prom1alp/heartin-hardware/PCB/Montage/pcbX1 comment.jpg

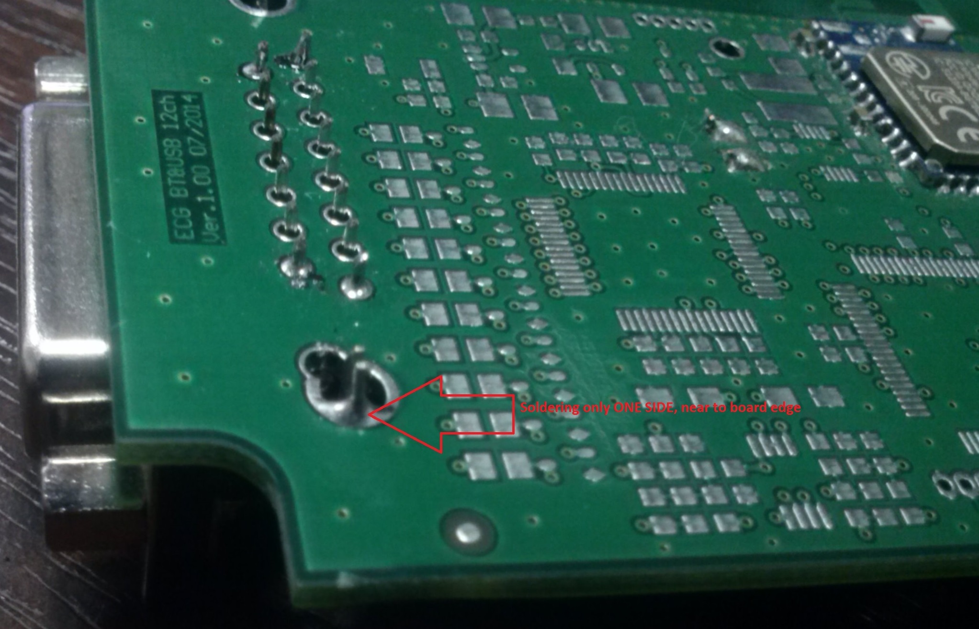
PCB/Montage/pcbX1 comment.jpg
