prom1alp/heartin-hardware/PCB/Montage/pcb overview.jpg

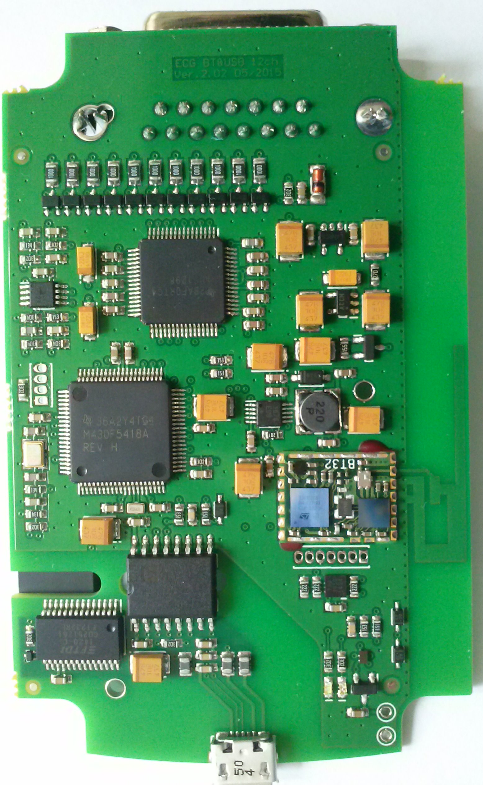
PCB/Montage/pcb overview.jpg
