prom1alp/heartin-hardware/PCB/Gerber/readme.txt

Имя:            ECG BT&USB 12ch Ver.2.02 05/2015
Тип:		4-х слойная печатная плата
Материал:	FR4
Размер:		54.61x87.50 мм (2.150'x3.445')
Толщина:	1.5мм
Электроконтроль:Да

Описание слоев:
TOP.GBR - проводники верхнего слоя
IN1.GBR - проводники внутреннего слоя 1
IN2.GBR - проводники внутреннего слоя 2
BOT.GBR	- проводники нижнего слоя
SMT.GBR - защитная маска верхнего слоя
SMB.GBR - защитная маска нижнего слоя
SST.GBR - маркировка верхнего слоя
SSB.GBR - маркировка нижнего слоя
BRD.GBR - контур платы

SPT.GBR	- паяльная паста верхнего слоя

Format:	RS274X, 2.4, Abs, Inch, Leading
Последовательность слоев: TOP-IN1-IN2-BOT

THRUHOLE.DRL	- файл сверловки метализированных отверстий

Format: Excellon 2, 2.4, Abs, Inch, Leading
