prom1alp/heartin-hardware/!Overview/box.png

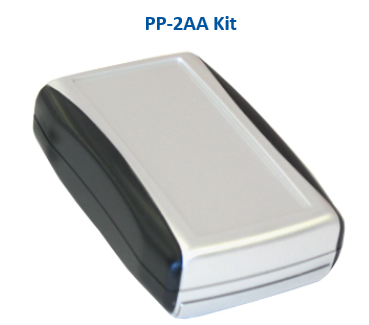
!Overview/box.png
