prom1alp/heartin-hardware/!Overview/box_overview.jpg

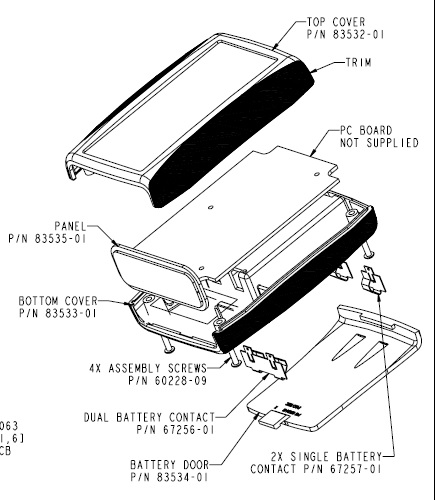
!Overview/box_overview.jpg
