prom1alp/heartin-hardware/!Overview/box_panel_milling.jpg

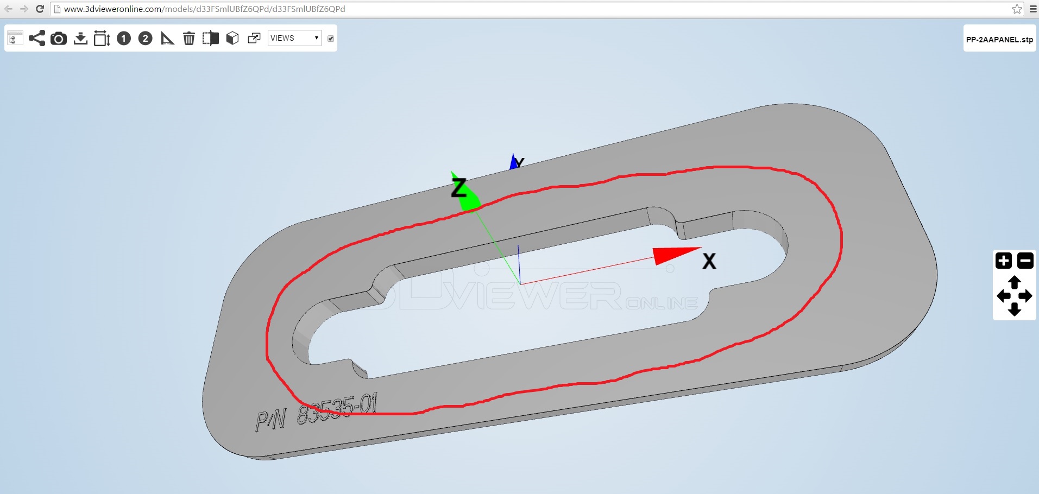
!Overview/box_panel_milling.jpg
