prom1alp/heartin-hardware/!Overview/box_top_milling.jpg

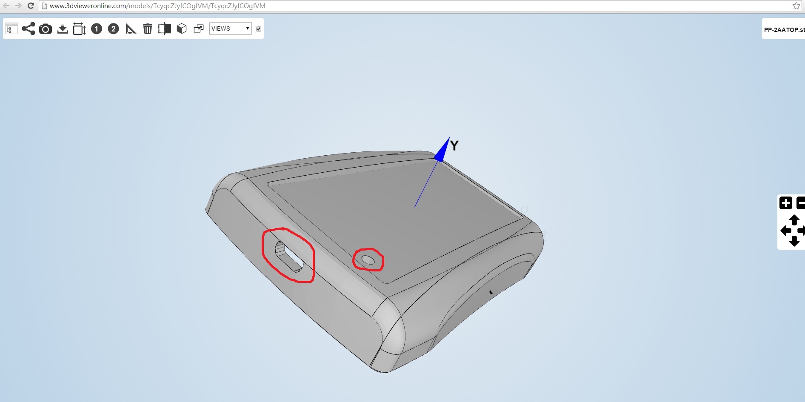
!Overview/box_top_milling.jpg
