prom1alp/heartin-hardware/Specification/drb-15f.jpg

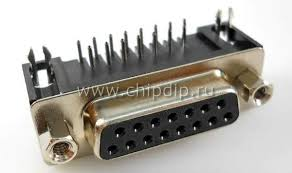
Specification/drb-15f.jpg
