prom1alp/heartin-hardware/Specification/pp-2aa.png

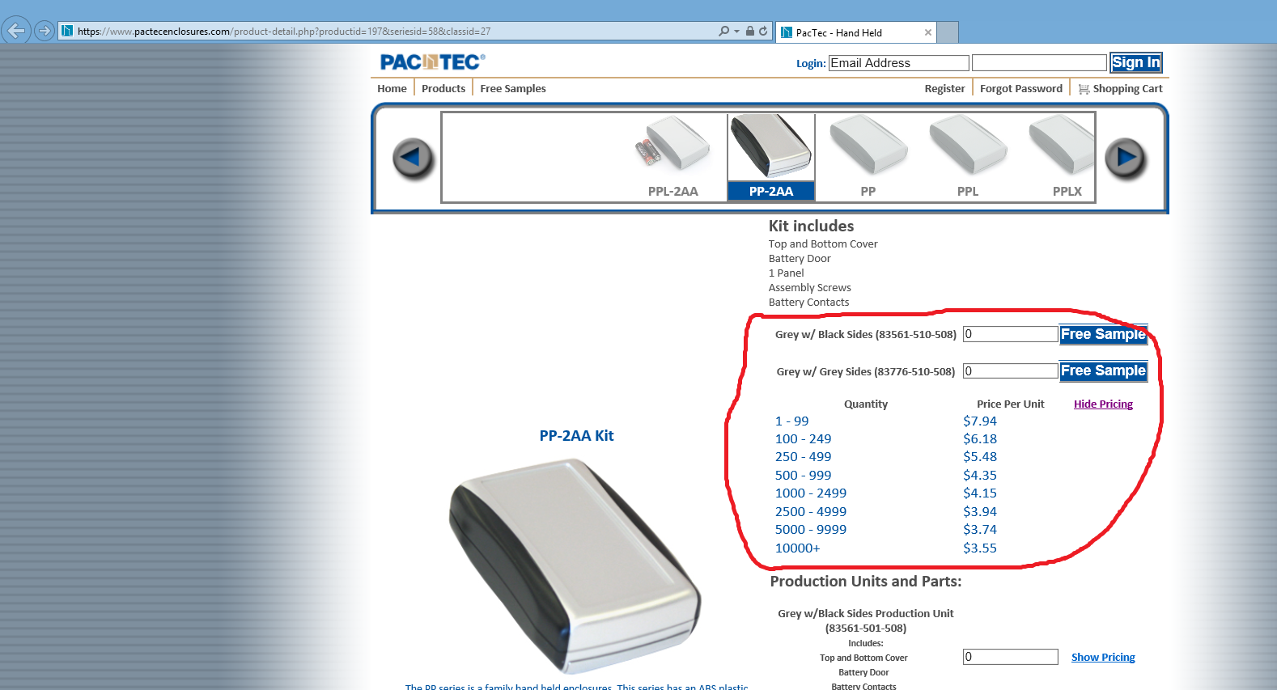
Specification/pp-2aa.png
