prom1alp/heartin-hardware/Specification/USB+BT+MFi (Apple)/Spec ECG BT&USB 12ch Ver.2.02 mod USB+BT+MFI.xls

ECG BT&USB 12ch Ver.2.02 05/2015
Обозначение | Наименование | Корпус | Кол. | Намменование производителя | Комментарий/Ссылка
C2, C3, C5, C6, C7, C8, C10, C15, C17, C19, C21, C24, C25, C32.X, C33, C35, C38, C42, C43, C44, C51, C52, C53, C55 | 0.1u | SMD0603 | 28 | CAP CER 0.1UF 10V 10% X7R 0603
C4 ,C30X | 10p | SMD0603 | 3 | CAP CER 10PF 50V 10% NP0 0603
C9 | 100p | SMD0603 | 1 | CAP CER 100PF 16V 10% X7R 0603
C11, C12, C28 | 22u 6V | TAJ-A | 3 | TAJA226K006RNJ
C13, C14, C16, C18, C20, C22, C31, C34, C36, C41, C45 | 1u | SMD0603 | 11 | CAP CER 1UF 10V 10% X7R 0603
C23, C26, C27, C29, C40, C46, C47, C48, C49, C50, C54 | 47u 10V | TAJ-B | 11 | TAJB476K010RNJ
C37 | 2n | SMD0603 | 1 | CAP CER 2000PF 50V 10% X7R 0603
C39, C56, C57 | 10n | SMD0603 | 3 | CAP CER 10000PF 50V 10% X7R 0603
D1.X | BAV99W | SOT323 | 11 | BAV99WT1G
D2 | BZV55-C5V6 | SOD80C | 1 | BZV55-C5V6,115
D3, D4, D8 | 1N4148WS | SOD323 | 3 | 1N4148WS
D5 | BLUE LED | SMD0603 | 1 | LTST-C191TBKT
D6 | GREEN LED | SMD0603 | 1 | LTST-C191KGKT
D7 | MBR0520L | SOD123 | 1 | MBR0520L
D9 | ESD7L5.0DT5G | SOT723 | 1 | ESD7L5.0DT5G
L1 | CDRH4D18NP-220NC |  | 1 | CDRH4D18NP-220NC or CDRH4D22HPNP-220MC or CDRH4D22HPNP-180MC or CDRH50D18RHF-220MC or LQH5BPN220MT0L or VLCF5024T-220MR59-2 or VLCF5020T-220MR58 or VLCF5020T-220MR75-1 | 18-22uH; Ferrite drum core construction; Magnetically shielded; 5 x 5 mm; height 1.8-2.4 mm; DC Current: 400 mA - 800mA; DC Resistance: 350 mOhms - 600 mOhms;
L2.X | BLM21PG221SN1D | SMD0805 | 3 | BLM21PG221SN1D
Q1, Q2 | IRLML6402 | SOT23 | 2 | IRLML6402TRPBF
R1.X | 100R | SMD0805 | 11 | Yageo RES 1/8W 1% 0805 SMD
R2, R3, R8, R14, R15, R16, R24, R25, R29, R30 | 3k | SMD0603 | 10 | Yageo RES 1/10W 5% 0603 SMD
R4, R10, R11, R20, R21, R26, R28 | 15k | SMD0603 | 7 | Yageo RES 1/10W 5% 0603 SMD
R5, R6, R7 | 300k | SMD0603 | 3 | Yageo RES 1/10W 5% 0603 SMD
R9, R22, R23 | 130k | SMD0603 | 3 | Yageo RES 1/10W 5% 0603 SMD
R12 | 27R | SMD0603 | 1 | Yageo RES 1/10W 1% 0603 SMD
R13 | 1.5M | SMD0603 | 1 | Yageo RES 1/10W 1% 0603 SMD
R17, R18, R19 | 2.2k | SMD0603 | 3 | Yageo RES 1/10W 1% 0603 SMD
R27 | 200R | SMD0603 | 1 | Yageo RES 1/10W 5% 0603 SMD
U1 | OP2177ARM | MSOP8 | 1 | OP2177ARMZ
U2 | ADS1298IPAG | PQFP64 | 1 | ADS1298IPAG
U3 | MC78LC50NTR | SOT23-5 | 1 | MC78LC50NTRG
U4 | MAX1683EUK | SOT23-5 | 1 | MAX1683EUK+T
U5 | MSP430F5418AIPN | PQFP80 | 1 | MSP430F5418AIPN
U6 | BT-32 |  | 1 | bluetooth module BT-32 with CUSTOM FW 141115C_CustomFlowCon (must be in PO with bin files and release notes) | http://www.ampedrf.com/sales_form.htm
U7 | Apple MFi |  | 1
U8 | FPF1320 | BGA6 | 1 | FPF1320UCX
U9 | MAX1676EUB | MSOP10 | 1 | MAX1676EUB+
U10 | ADuM6201CRWZ | SOIC16 | 1 | ADUM6201CRWZ
U11 | FT232RL | SSOP28 | 1 | FT232RL
U12 | LTV-827S | SMD DIP8 | 1 | LTV-827S
X1 | DBR-15F |  | 1 | FCI 10090099-S154VLF or FCI D15S33E4GV00LF | D-Sub Receptacle; Female Sockets; 15 pin; Through Hole, Right Angle; Mating Side; Female Screwlock (4-40)
X4 | 47346-0001 |  | 1 | Molex Micro USB 0473460001
Y1 | 24.576MHz | KX-7 | 1 | GEYER KX-7 24.576MHz (12.88666 - http://www.geyer-electronic.com/uploads/tx_userartikelfrequenzstockfr/12.88666.pdf) or EPSON FA-238 24.5760MB-K3
Y2 | KX-327RT | KX-327RT | 1 | GEYER KX-327RT (12.87160 - http://www.geyer-electronic.com/uploads/tx_userartikelfrequenzstockfr/12.87160_02.pdf) or SEIKO SC20S-12.5PF20PPM
BOX | PP-2AA Kit | ECG BOX | 1 | PacTec Grey w/ Grey Sides (83776-510-508) or Grey w/ Black Sides (83561-510-508) | https://www.pactecenclosures.com/product-detail.php?productid=197&seriesid=58&classid=27
