prom1alp/heartin-hardware/Specification/pcb_bom_comment.jpg

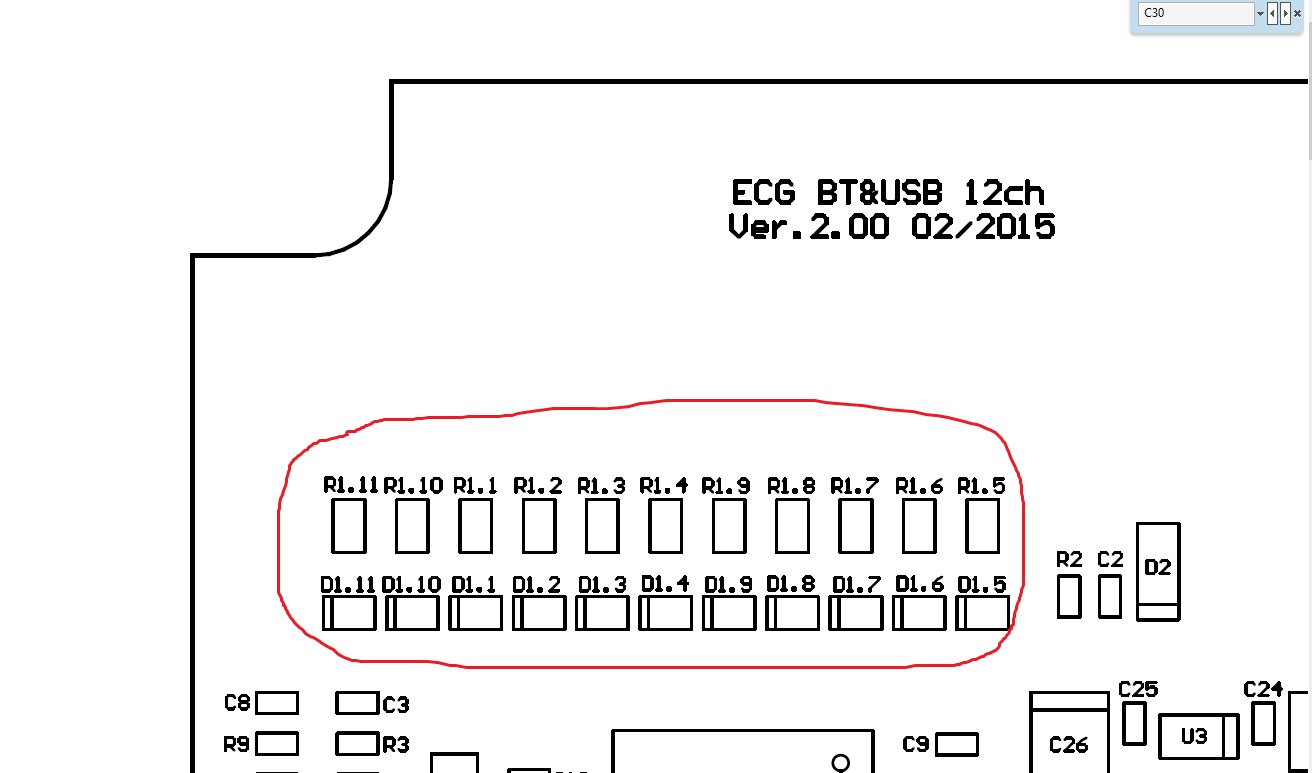
Specification/pcb_bom_comment.jpg
