prom1alp/heartin-hardware/Box/Milling model/PP-2AA TOP.stp

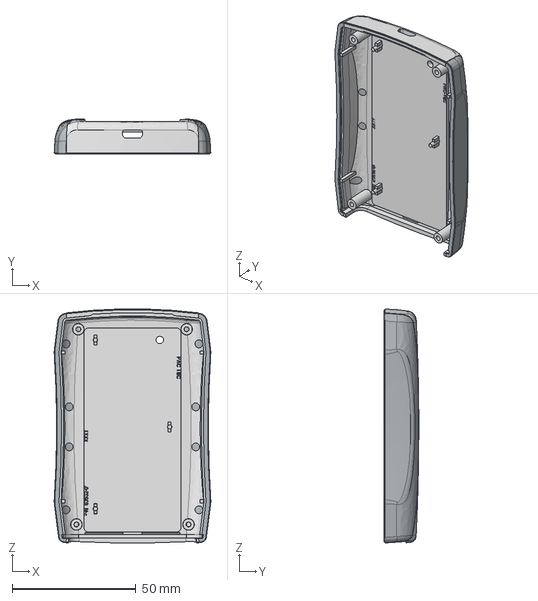
[picture p10: CAD file, 2016-02-01]
Box/Milling model/PP-2AA TOP.stp
63.2 x 14.0 x 94.4 mm
