prom1alp/heartin-hardware/Box/Milling model/PP-2AA PANEL.stp

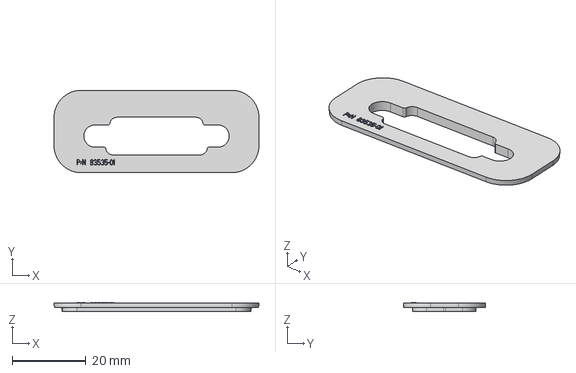
[picture p11: CAD file, 2016-02-01]
Box/Milling model/PP-2AA PANEL.stp
55.5 x 22.3 x 2.44 mm
