prom1alp/heartin-hardware/!YOU KNOW HOW Firmware/Shematic/ECG BT&USB 12ch Ver.2.01 SCH.pdf

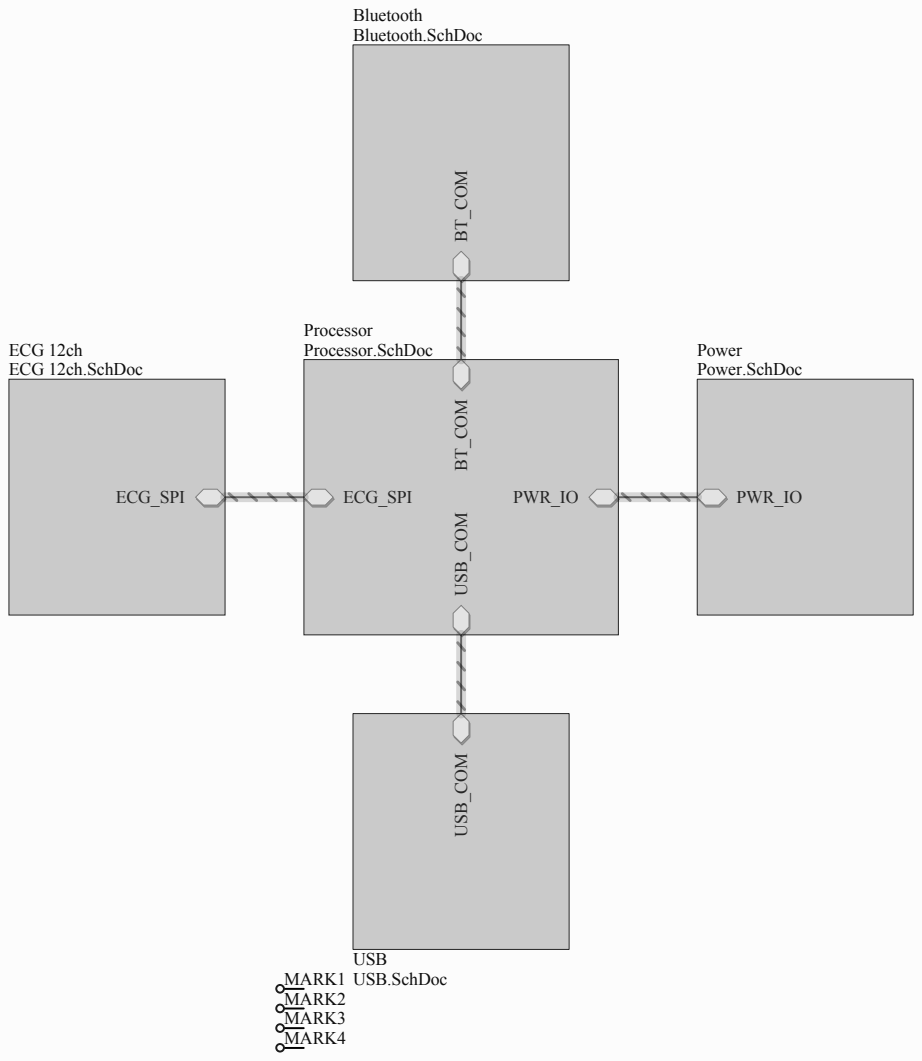
[picture p12: page 1]
Title; Size; Number; Revision; Date:; Sheet of; File:; D:\Projects\..\Main 12ch.SchDoc; Drawn By:; ECG_SPI; ECG 12ch ECG 12ch.SchDoc; BT_COM; USB_COM; PWR_IO; Processor Processor.SchDoc; MARK1 MARK2 MARK3 MARK4; Bluetooth Bluetooth.SchDoc; USB USB.SchDoc; Power Power.SchDoc

IN1P 16 | IN1N 15 | IN2P 14 | IN2N 13 | IN3P 12 | IN3N 11 | IN4P 10 | IN4N 9 | IN5P 8 | IN5N 7 | IN6P 6 | IN6N 5 | IN7P 4 | IN7N 3 | IN8P 2 | IN8N 1

## Rin Lin Fin

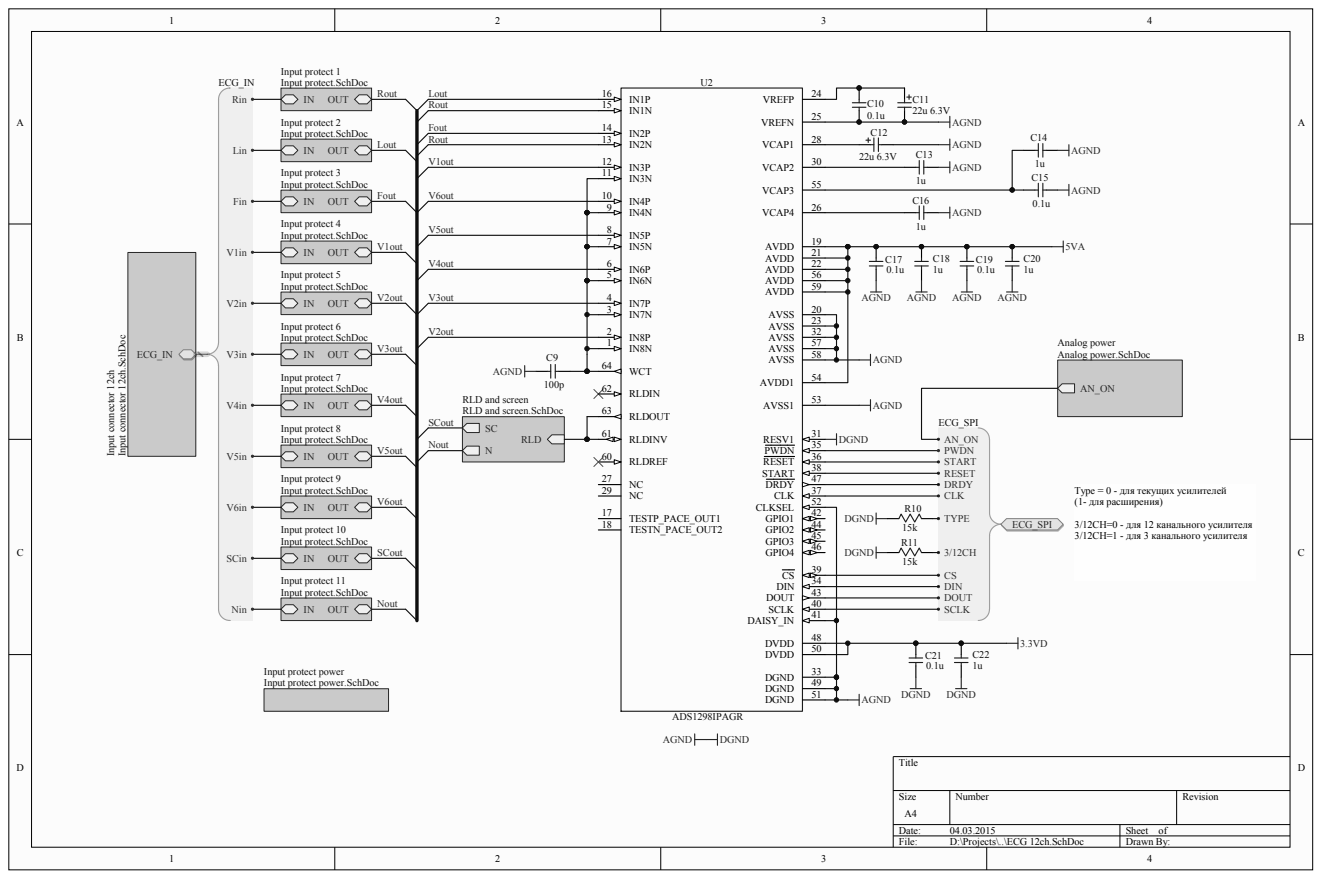
[picture p13: page 2]

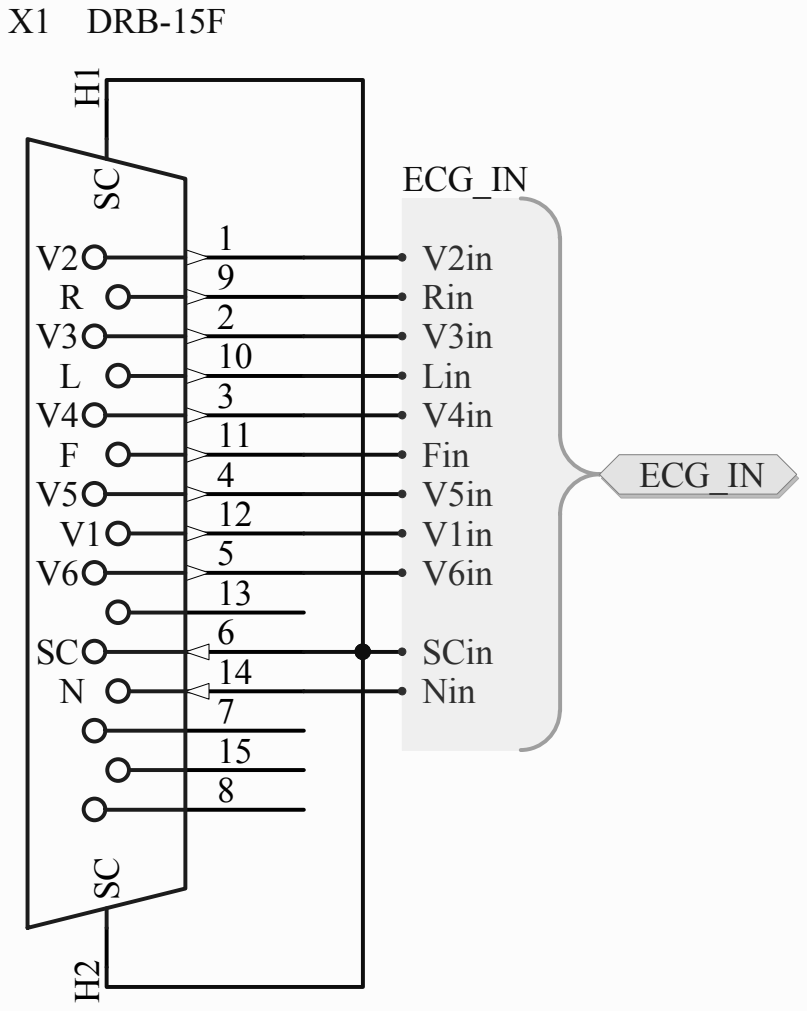
[picture p14: page 3]
Title; Size; Number; Revision; File:; D:\Projects\..\Input connector 12ch.SchDocDrawn By:; DRB-15F; Rin; Lin; Fin; SCin Nin; ECG_IN

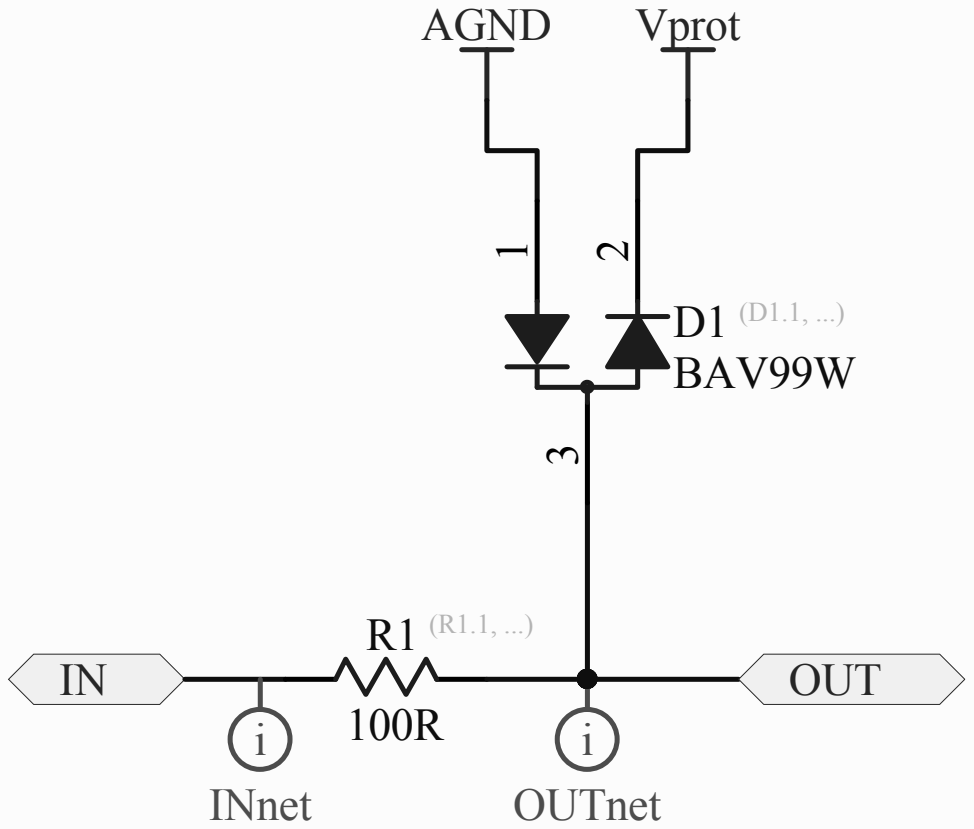
[picture p15: page 4]
Title; Size; Number; Revision; File:; D:\Projects\..\Input protect.SchDoc; Drawn By:; OUT; AGND; Vprot; BAV99W; i INnet; i OUTnet

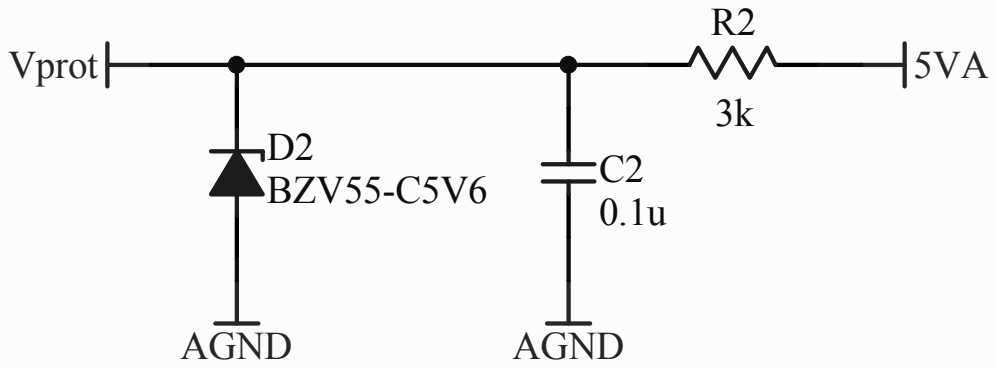
[picture p16: page 5]
Title; Size; Number; Revision; File:; D:\Projects\..\Input protect power.SchDoc Drawn By:; Vprot; AGND; BZV55-C5V6

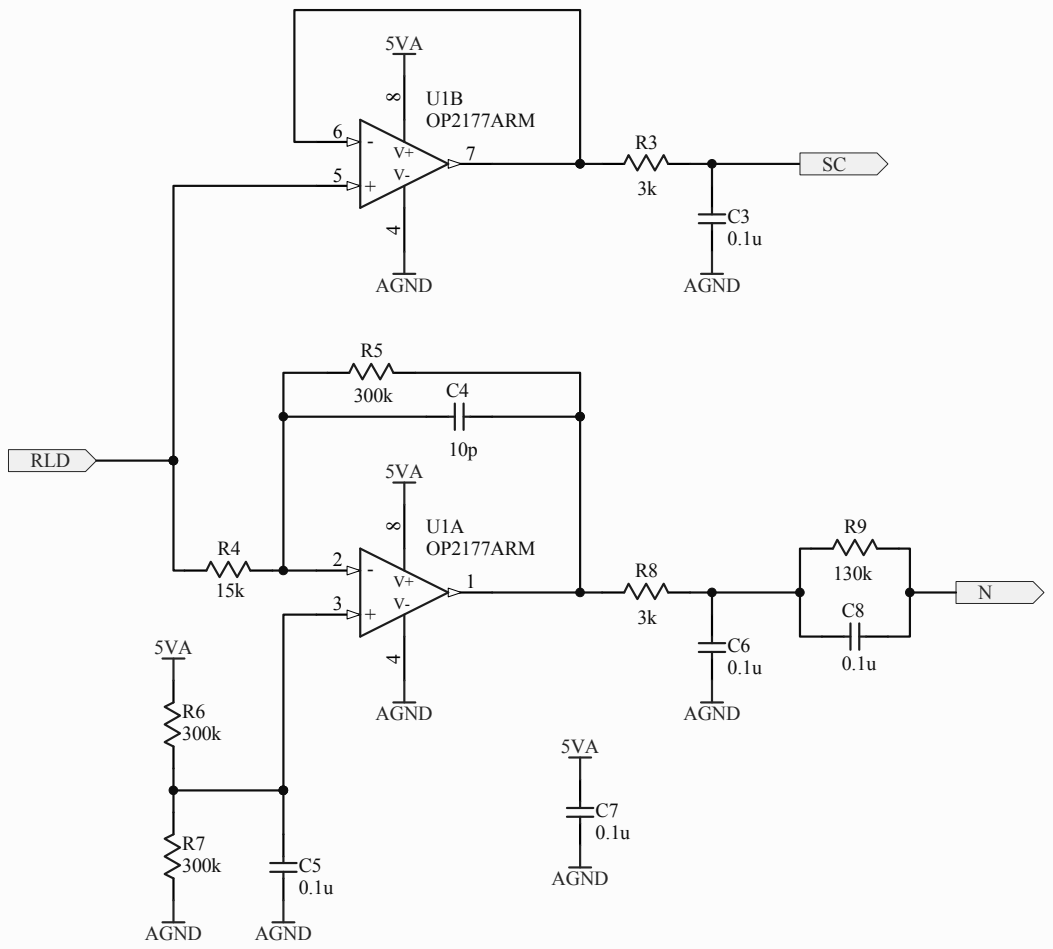
[picture p17: page 6]

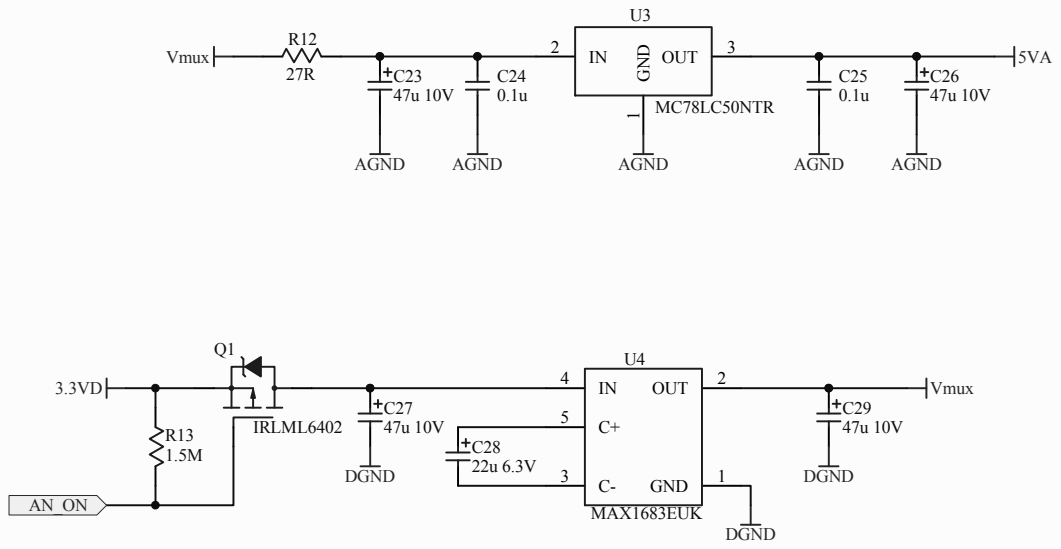
[picture p18: page 7]

# CLK DIN

# RESET 3/12CH

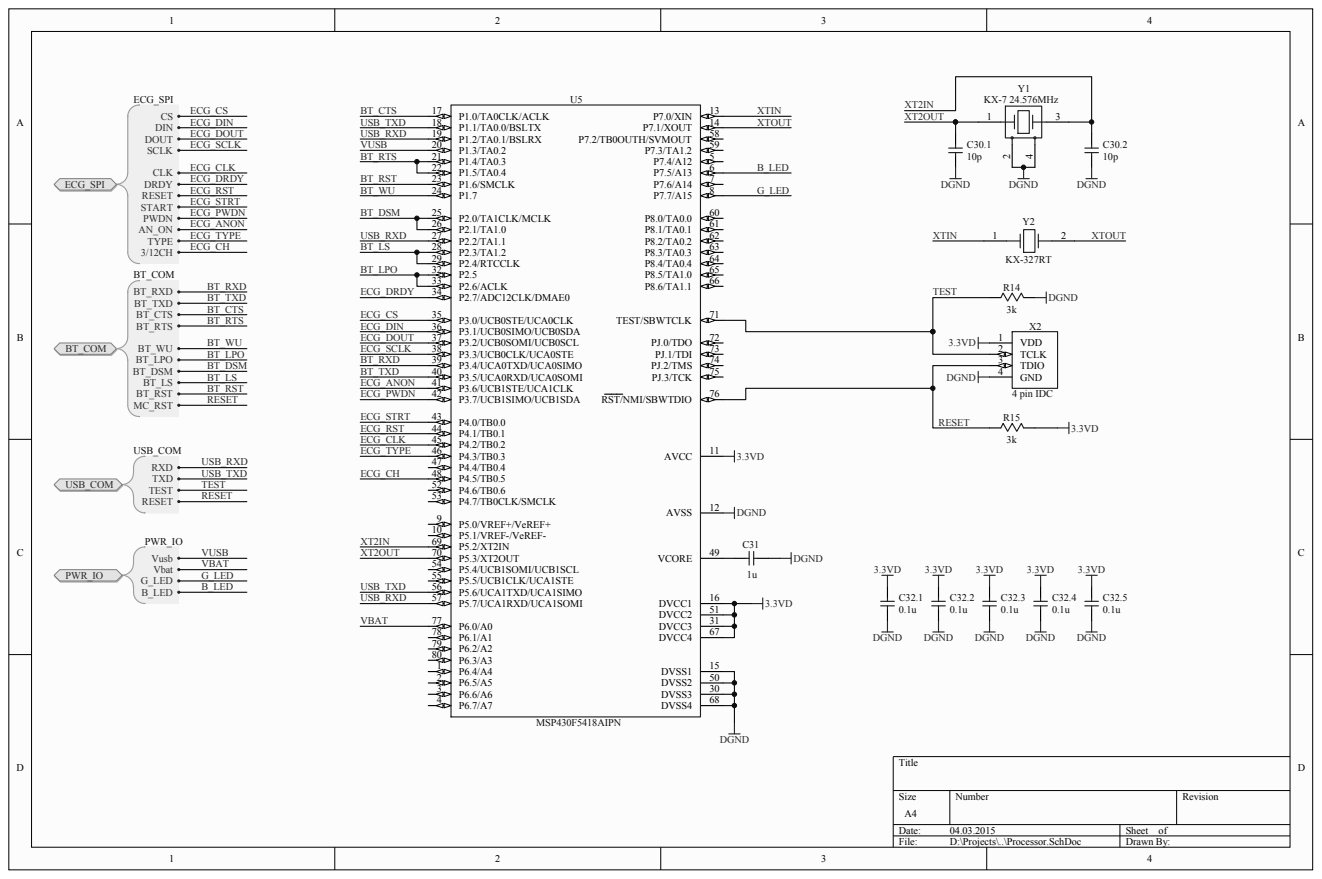
[picture p19: page 8]

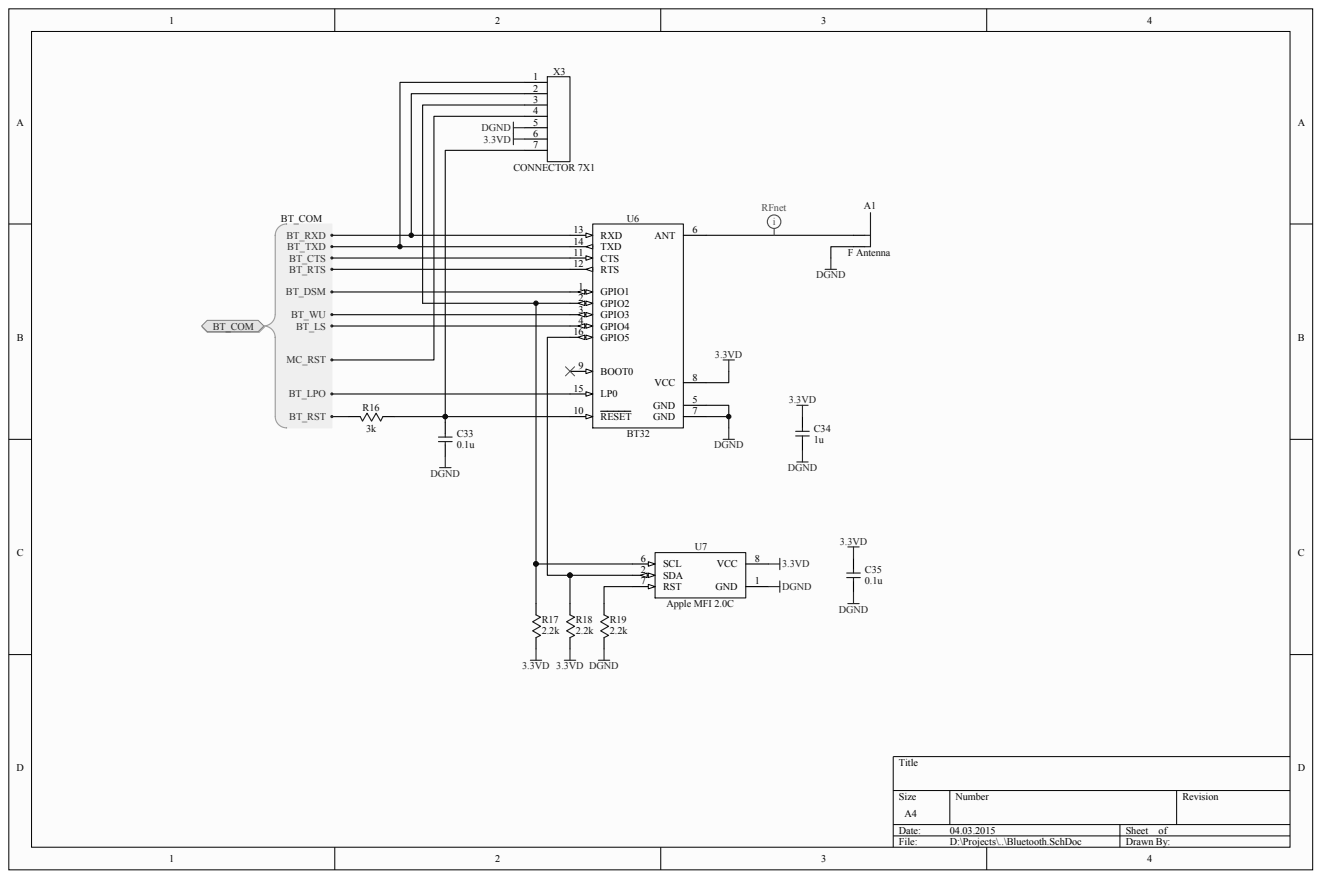
[picture p20: page 9]

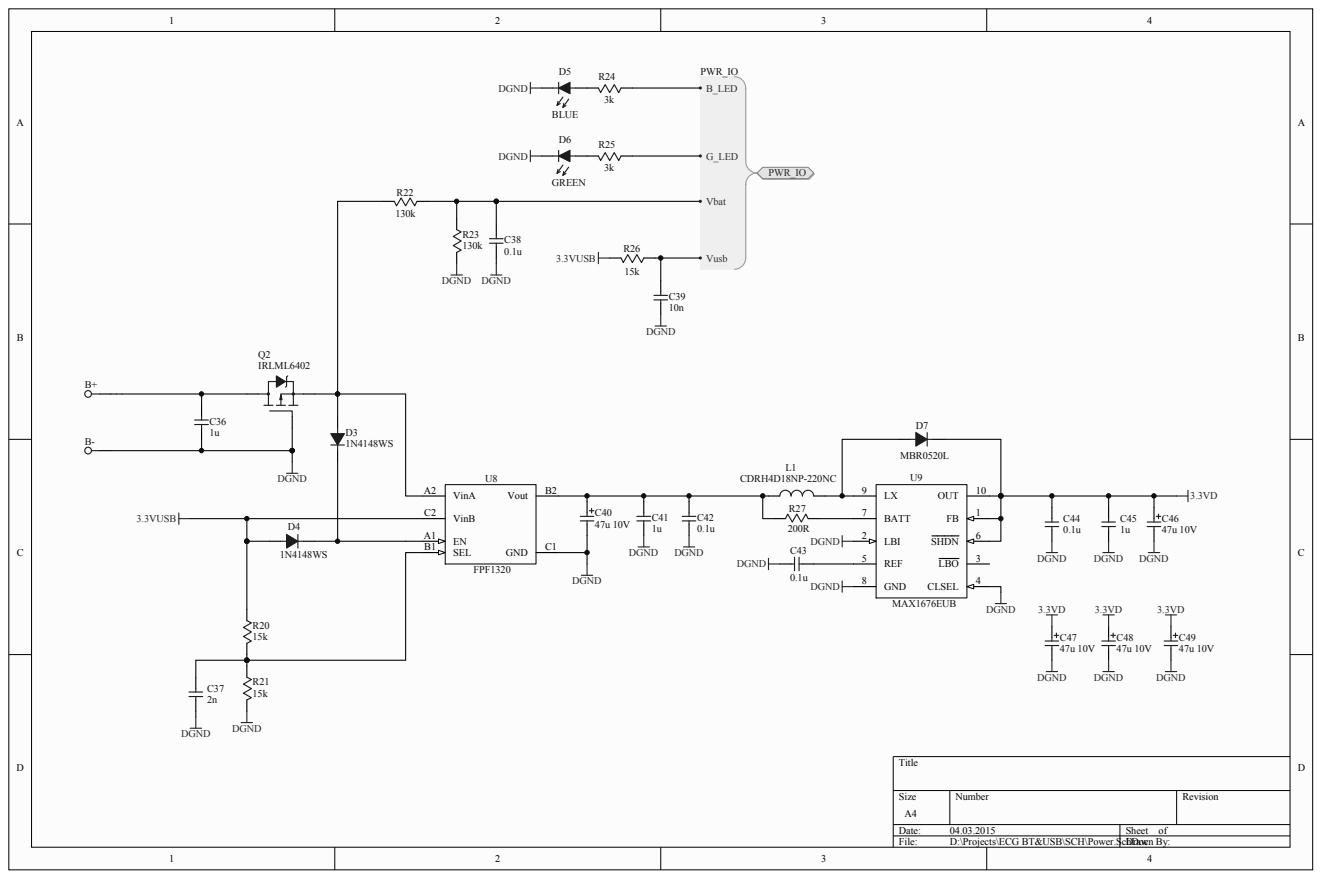
[picture p21: page 10]

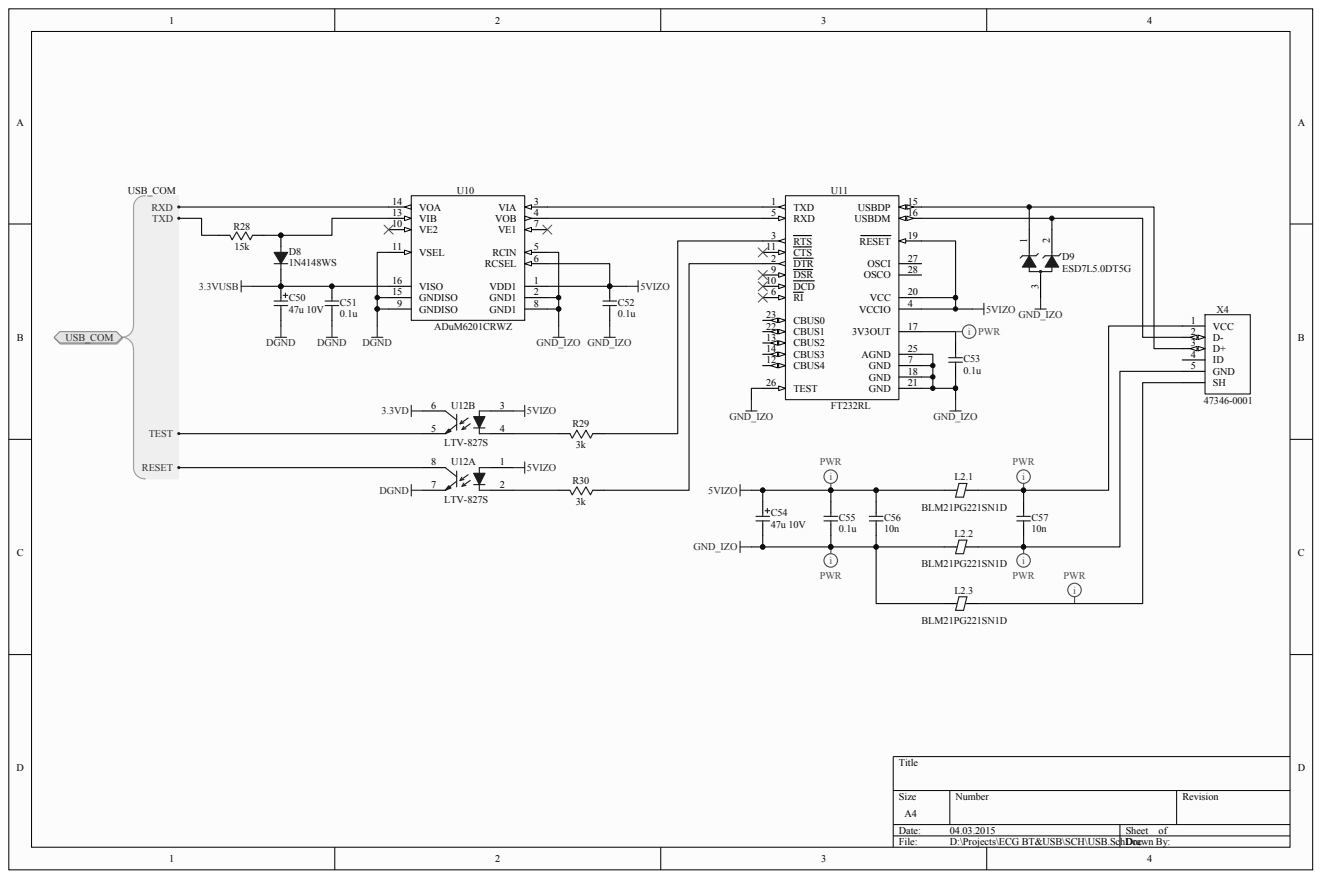
[picture p22: page 11]
