prom1alp/heartin-hardware/PCB/Montage/ECG BT&USB 12ch Ver.2.02.pdf

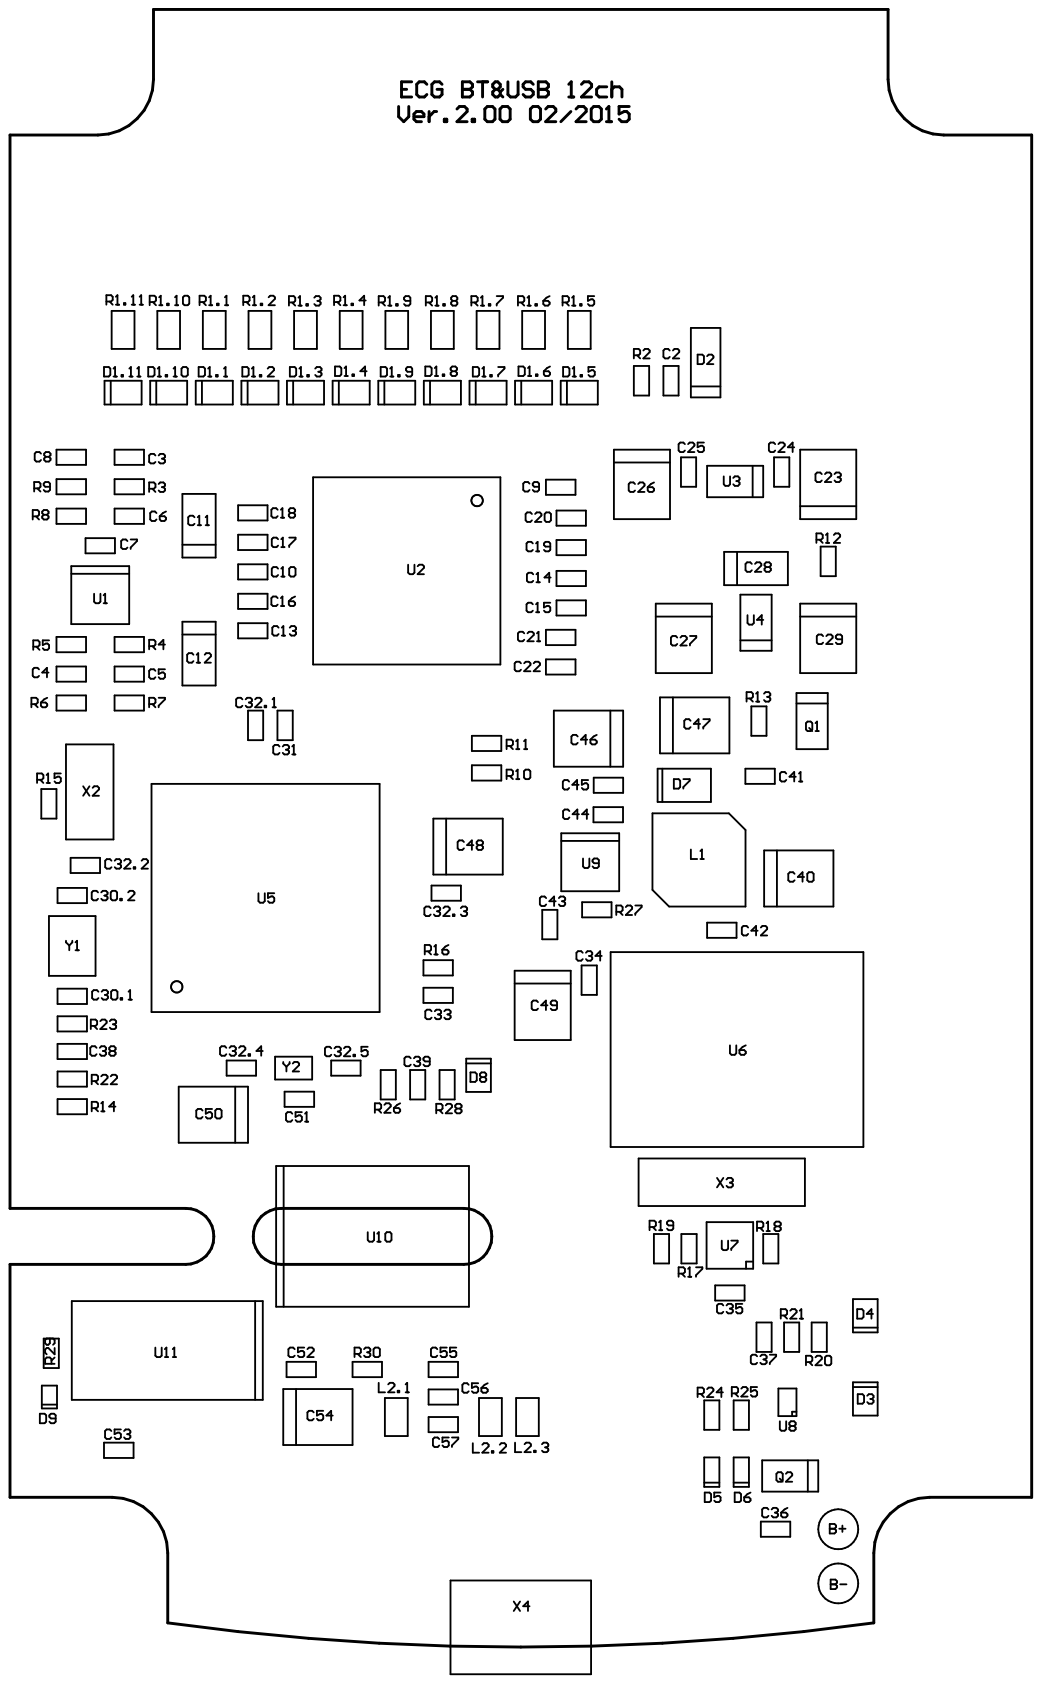
[picture p23: page 1]

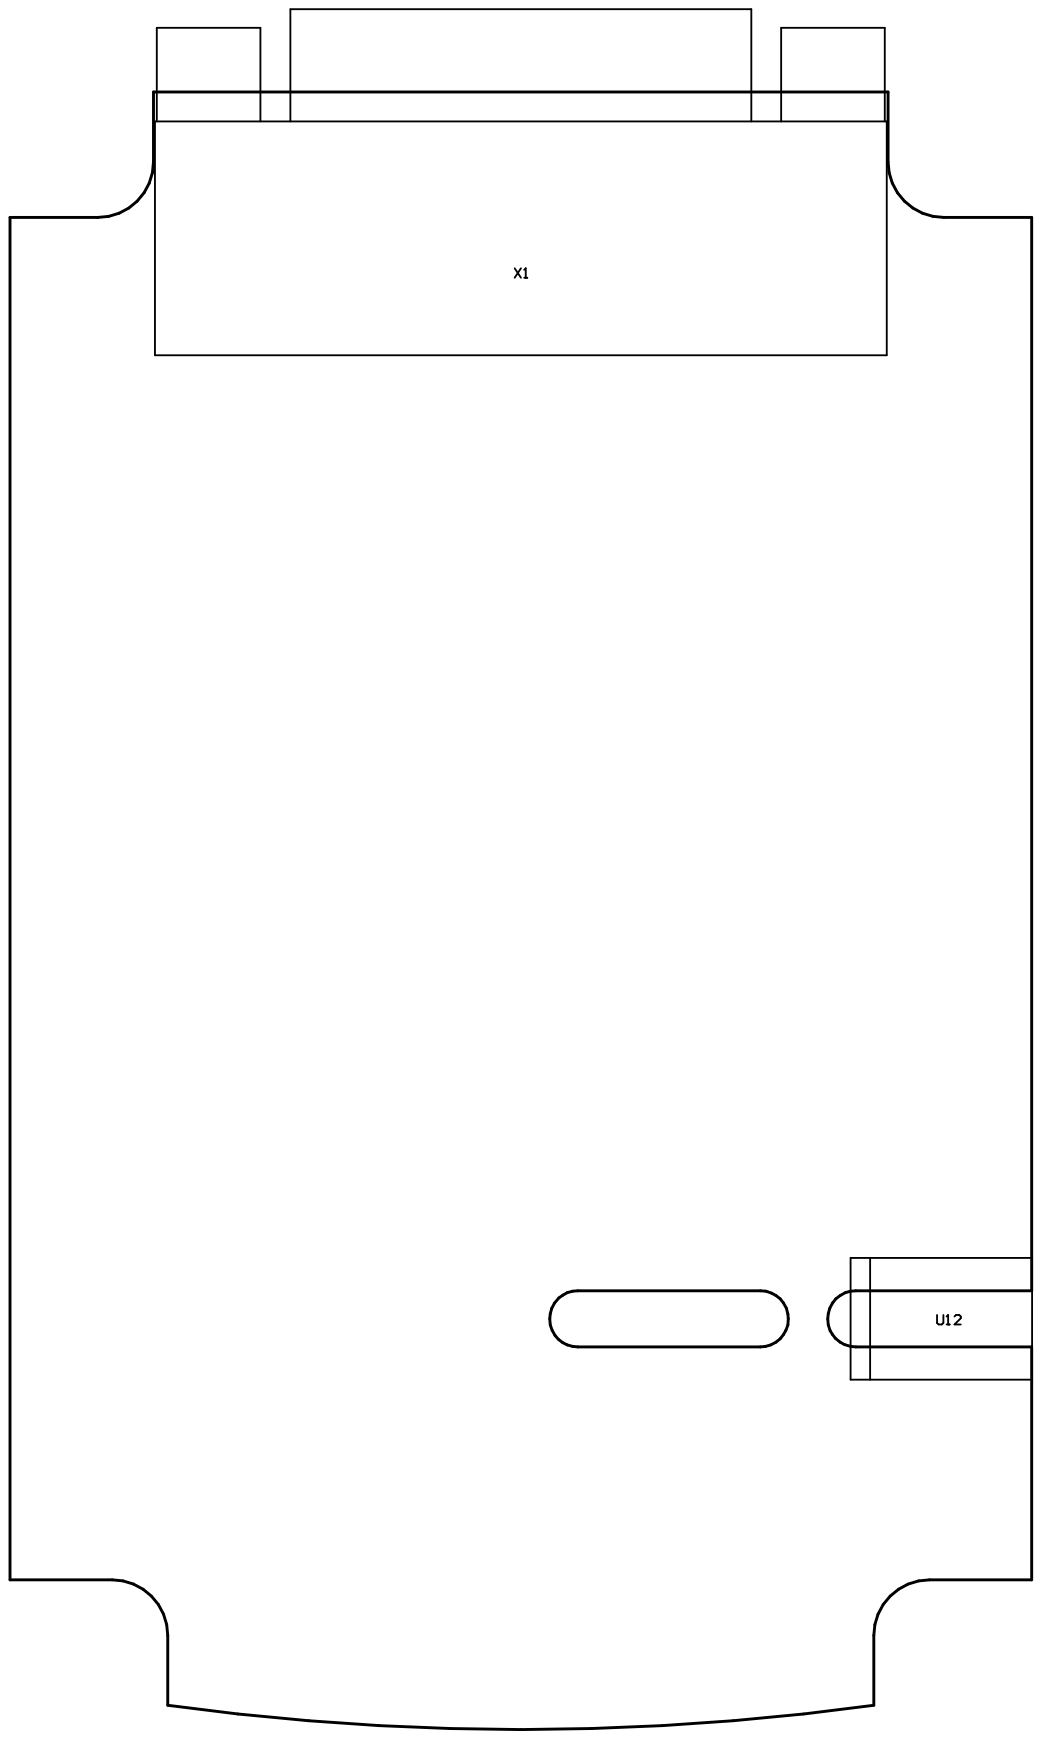
[picture p24: page 2]
