prom1alp/heartin-hardware/!YOU KNOW HOW Firmware/Shematic/Bluetooth_path.pdf

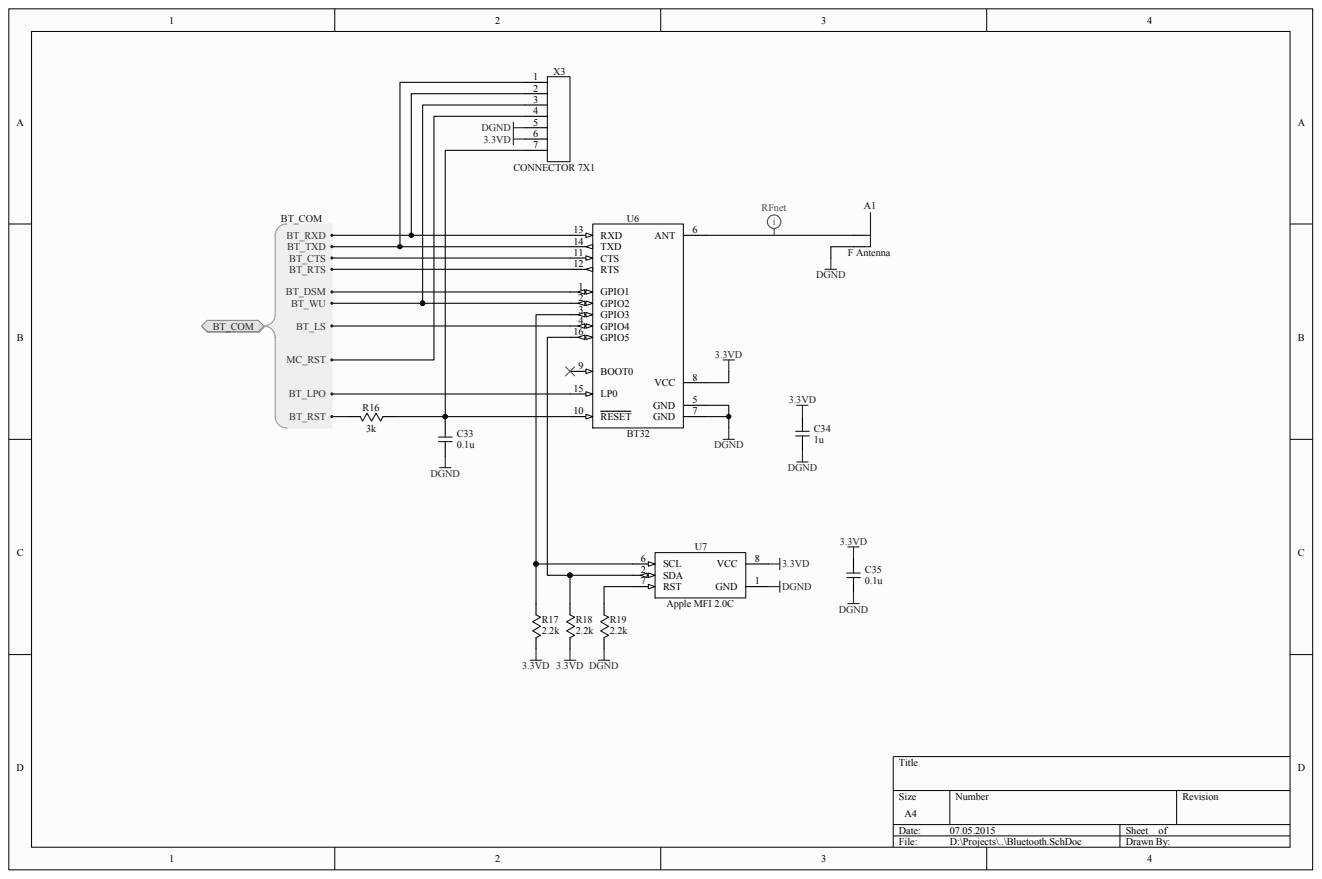
[picture p25: page 1]
