prom1alp/heartin-hardware/Box/Face/Fa·e.pdf

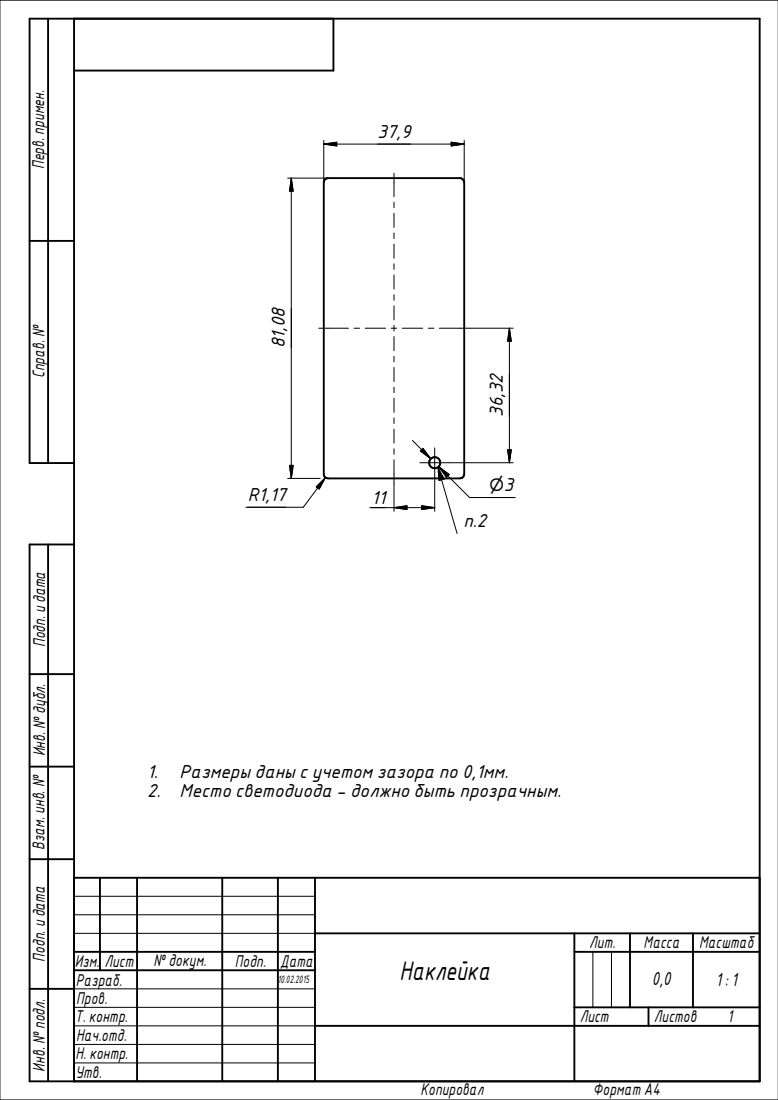
[picture p26: page 1]
Копировал; Формат A4; Инв. №; под; л. Под; Вза; бл. Под; Перв. п; мен.

1. Размеры даны с учетом зазора по 0,1мм.
2. Место светодиода - должно быть прозрачным.

Наклейка | Лит. | Масса | Масштаб

Изм. Лист | № докум. | Подп. | Дата | | | | | 0,0 | 1 : 1
Разраб. | | | 10.02.2015
Пров.
Т. контр. | | | | Лист | Листов 1
Нач.отд.
Н. контр.
Утв.
