prom1alp/heartin-hardware/Box/Milling model/drw_PP-2AA.pdf

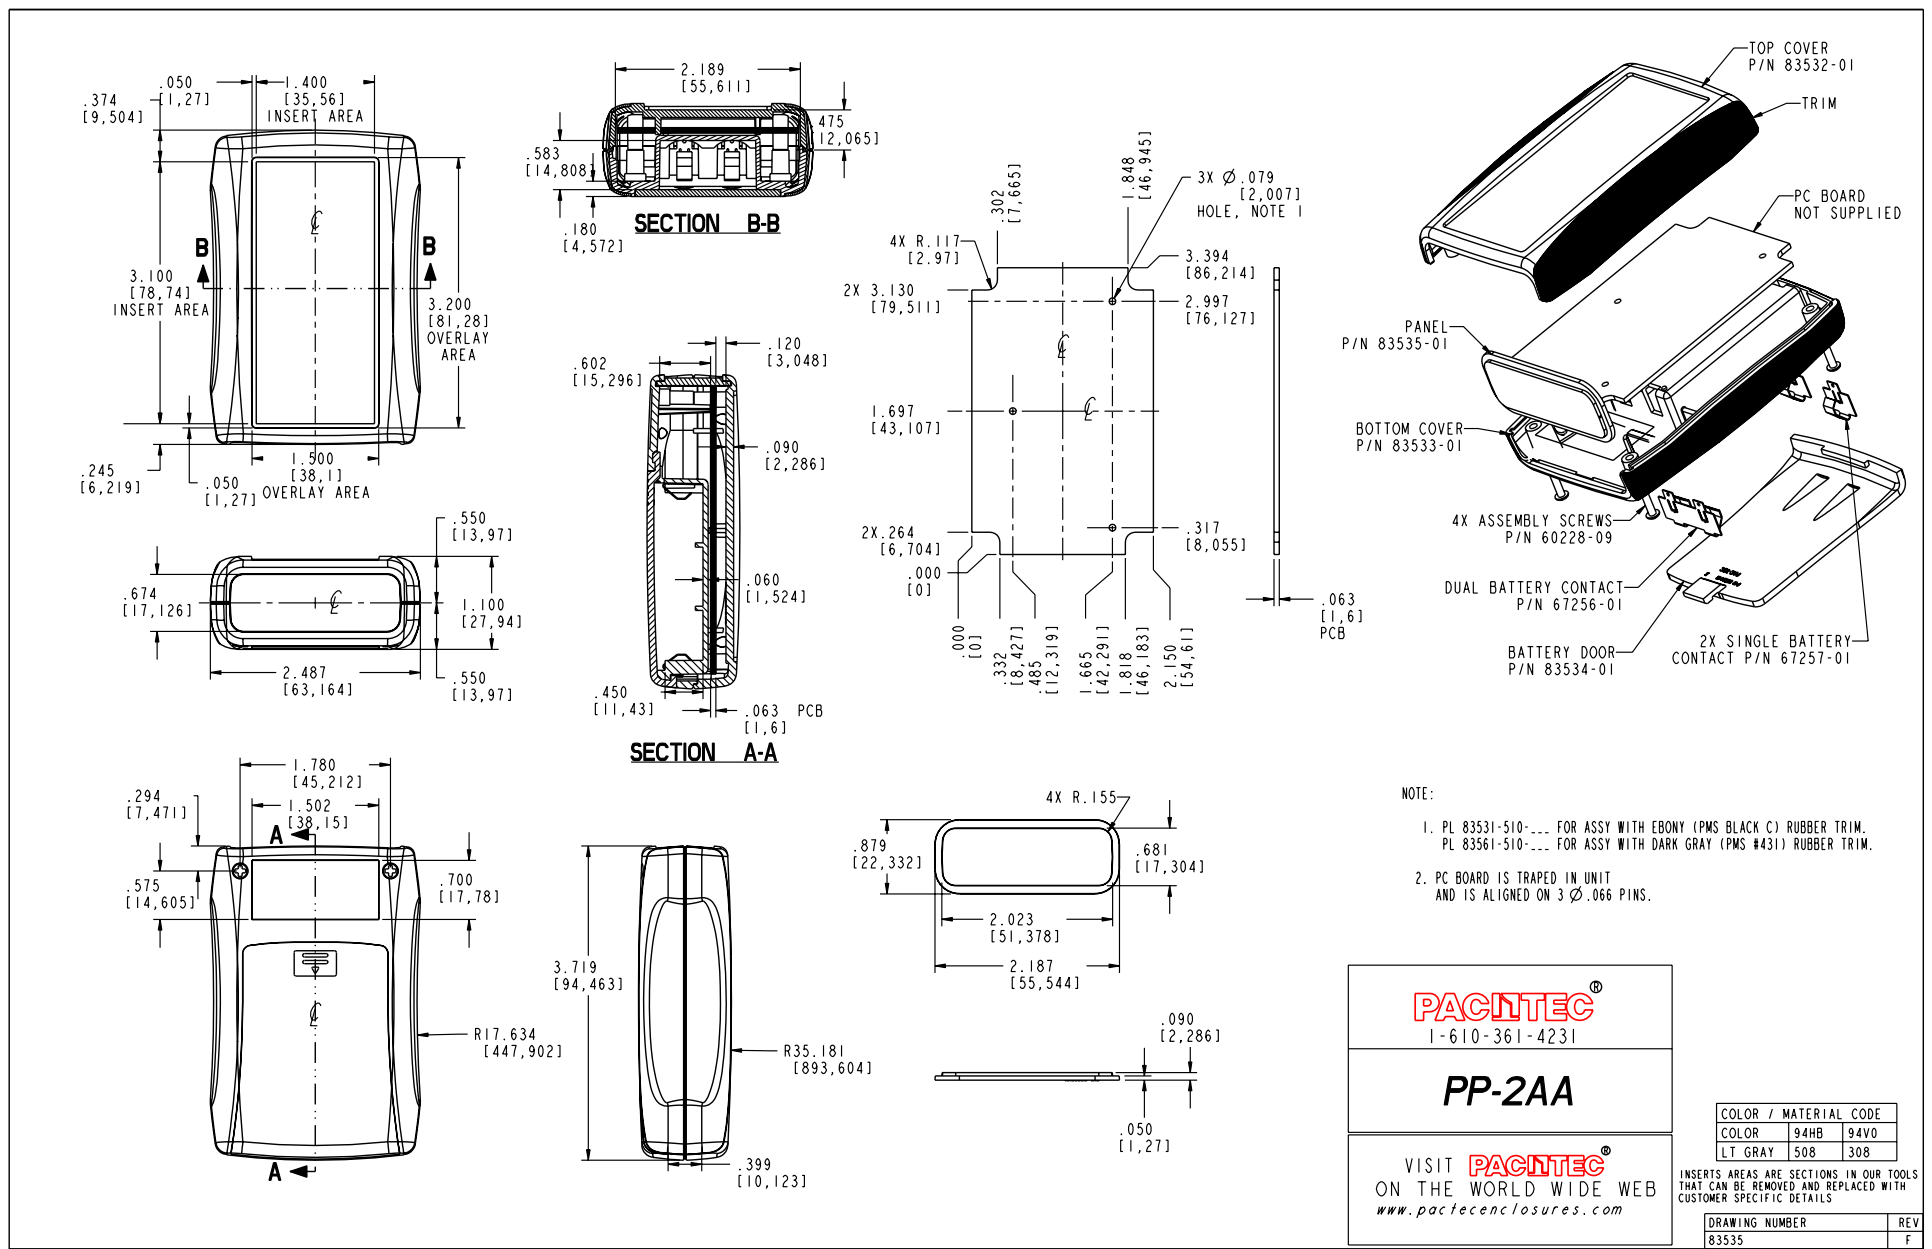
[picture p27: page 1]
