prom1alp/heartin-hardware/(list of files, drawings)

Other design files:
!YOU KNOW HOW Firmware/Shematic/Project/Analog power.SchDoc
!YOU KNOW HOW Firmware/Shematic/Project/Bluetooth.SchDoc
!YOU KNOW HOW Firmware/Shematic/Project/ECG 12ch.SchDoc
!YOU KNOW HOW Firmware/Shematic/Project/ECG BT&USB 12ch.PrjPcb
!YOU KNOW HOW Firmware/Shematic/Project/Input connector 12ch.SchDoc
!YOU KNOW HOW Firmware/Shematic/Project/Input protect power.SchDoc
!YOU KNOW HOW Firmware/Shematic/Project/Input protect.SchDoc
!YOU KNOW HOW Firmware/Shematic/Project/Main 12ch.SchDoc
!YOU KNOW HOW Firmware/Shematic/Project/Power.SchDoc
!YOU KNOW HOW Firmware/Shematic/Project/Processor.SchDoc
!YOU KNOW HOW Firmware/Shematic/Project/RLD and screen.SchDoc
!YOU KNOW HOW Firmware/Shematic/Project/USB.SchDoc
PCB/Montage/ECG BT&USB 12ch Ver.2.02.PcbDoc
PCB/Montage/ECG BT&USB 12ch.PcbDoc
